RyokaL/CS5041-Interactive-Display-Theremin/IMG_20210315_143000.jpg

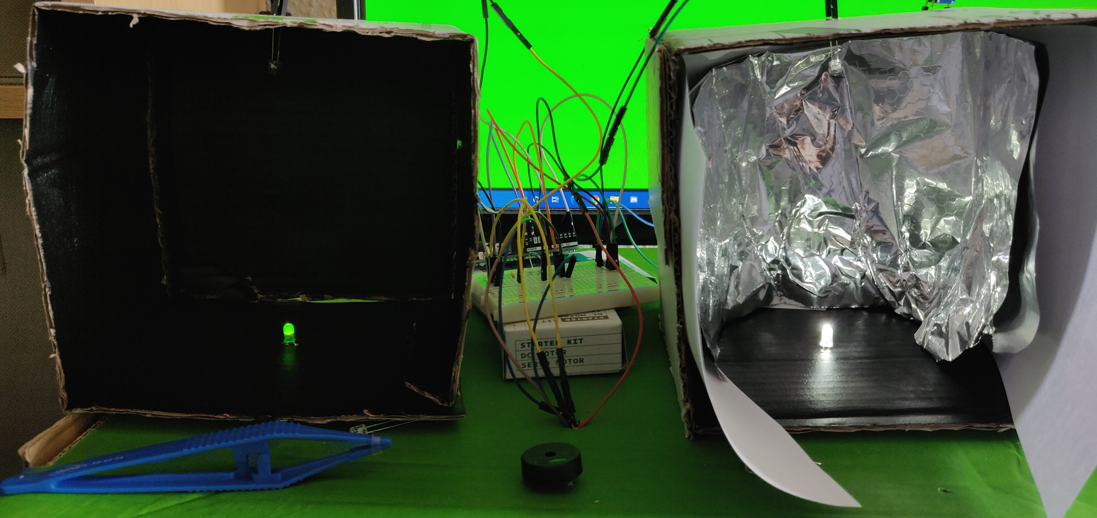
IMG_20210315_143000.jpg
