RyokaL/CS5041-Interactive-Display-Theremin/README.md

# CS5041 Interactive Display Theremin
 Practical 2 for CS5041, creating an interactive exhibit. My exhibit utilised an Arduino with light sensors to create a light theremin
